smarticleparticle/scent-sync/hardware/CAD/TopHolder1.stl

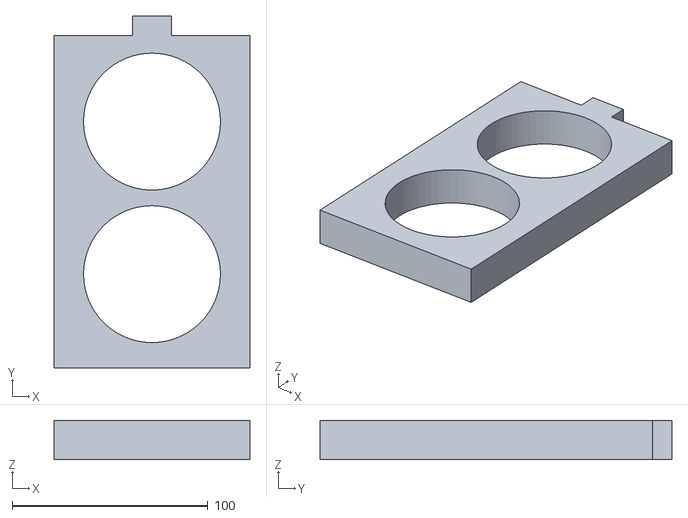
[picture p1: CAD file, 2026-04-13]
hardware/CAD/TopHolder1.stl
100.0 x 180.0 x 20.0
