smarticleparticle/scent-sync/hardware/CAD/BottomHolder2.stl

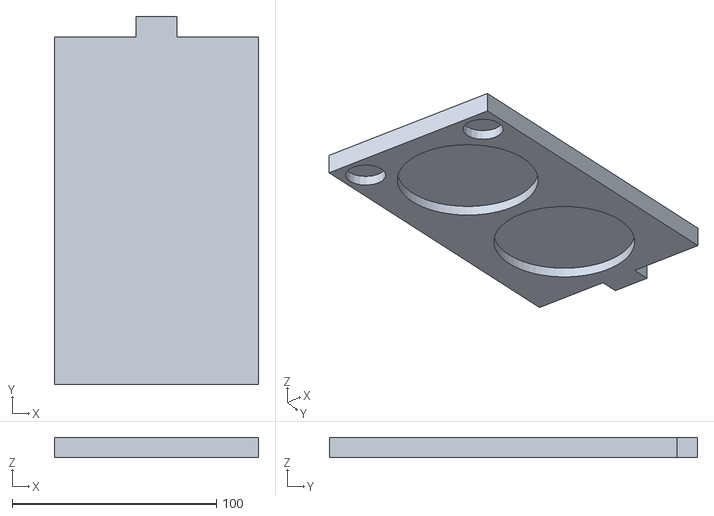
[picture p2: CAD file, 2026-04-13]
hardware/CAD/BottomHolder2.stl
100.0 x 180.0 x 10.0
