smarticleparticle/scent-sync/hardware/CAD/TopHolder2.stl

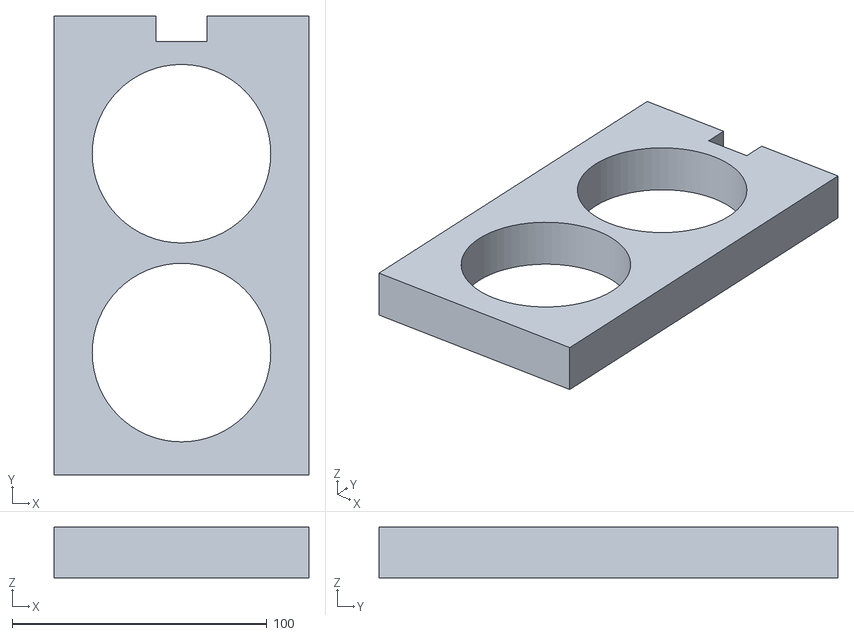
[picture p3: CAD file, 2026-04-13]
hardware/CAD/TopHolder2.stl
100.0 x 180.0 x 20.0
