smarticleparticle/scent-sync/hardware/CAD/BottomHolder1.stl

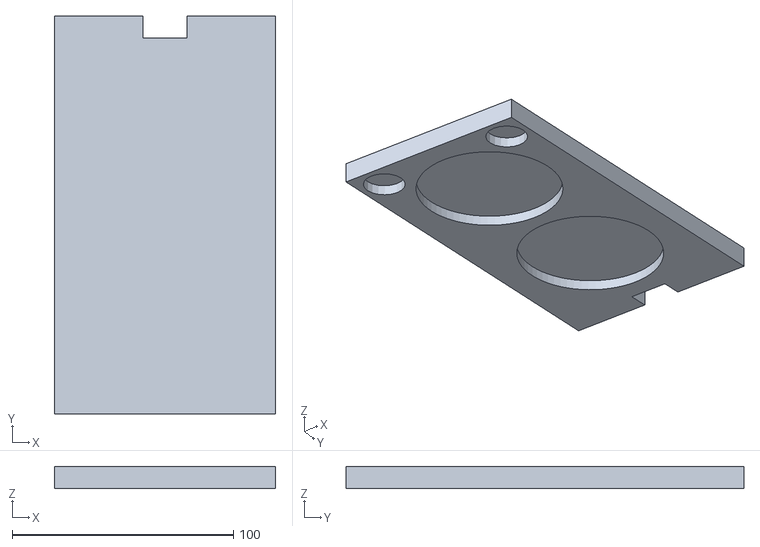
[picture p4: CAD file, 2026-04-13]
hardware/CAD/BottomHolder1.stl
100.0 x 180.0 x 10.0
