smarticleparticle/scent-sync/hardware/CAD/ArduinoCase.stl

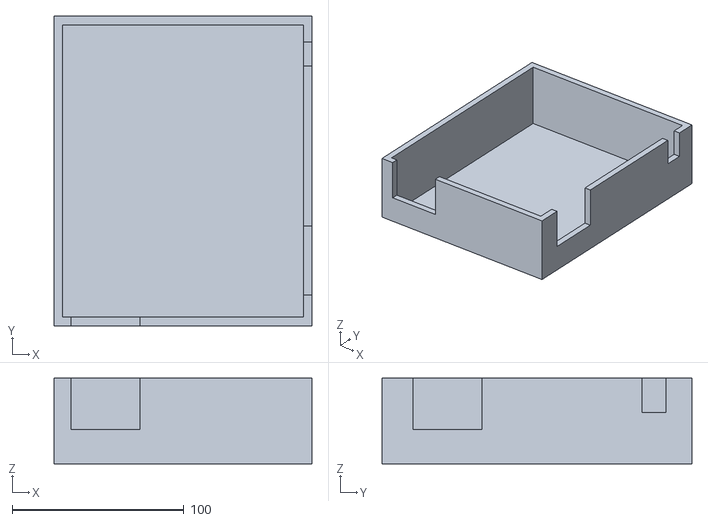
[picture p5: CAD file, 2026-04-13]
hardware/CAD/ArduinoCase.stl
150.0 x 180.0 x 50.0
