smarticleparticle/scent-sync/hardware/CAD/HolderSupport.stl

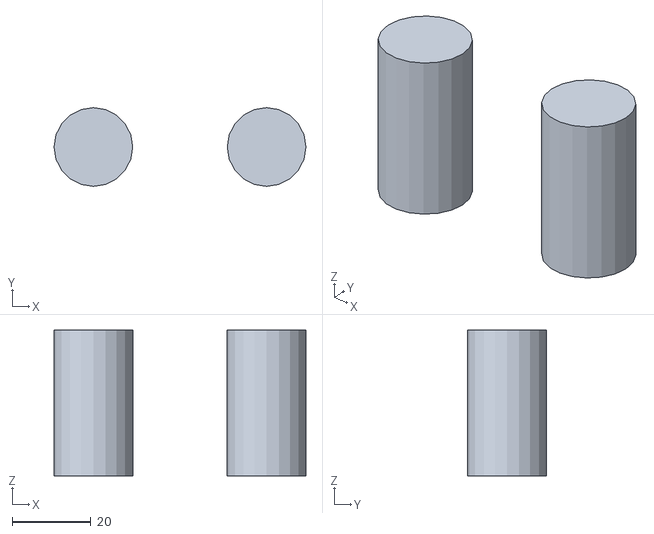
[picture p6: CAD file, 2026-04-13]
hardware/CAD/HolderSupport.stl
64.0 x 20.0 x 37.0
