smarticleparticle/scent-sync/hardware/CAD/Tube_Cap.stl

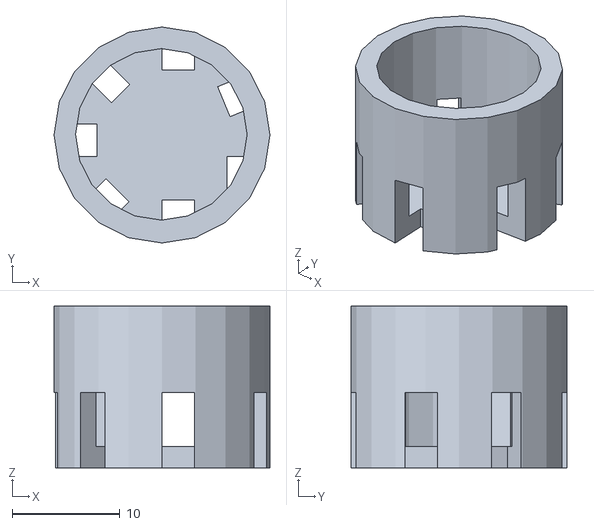
[picture p7: CAD file, 2026-04-13]
hardware/CAD/Tube_Cap.stl
20.0 x 20.0 x 15.0
