smarticleparticle/scent-sync/hardware/schematics/olfactometer_schematic.pdf

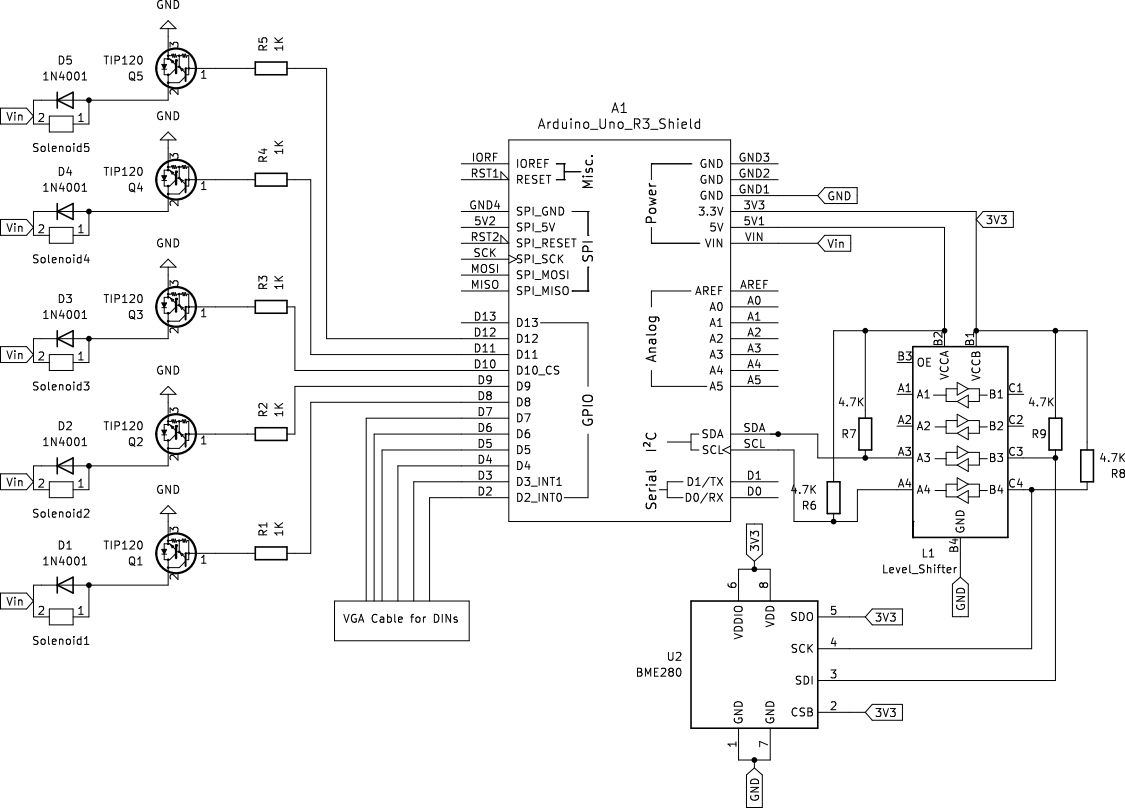
[picture p8: page 1]
