smarticleparticle/scent-sync/analysis/figure_sources/figure1_left_infographic.pdf

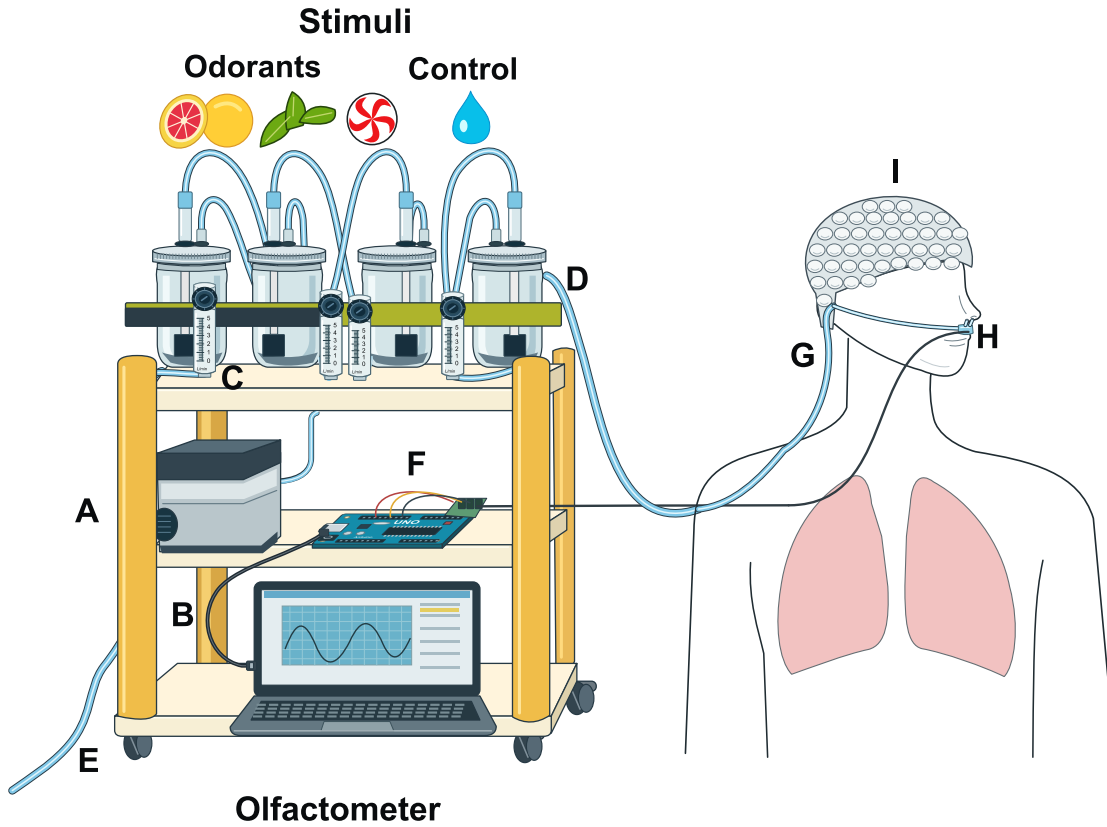
[picture p9: page 1]
