smarticleparticle/scent-sync/(commit log)

2026-04-10 Create BOM.csv
    Bill of Materials
    [BOM.csv]
2026-04-13 Rename hardware/Lid cap slower (3).stl to hardware/cad/tube_cap.stl
    [tube_cap.stl]
2026-04-13 Rename Arduino Case Second version.stl to ArduinoCase.stl
    [ArduinoCase.stl]
2026-04-13 Rename Bottom Half 1.stl to BottomHolder1.stl
    [BottomHolder1.stl]
2026-04-13 Rename Bottom Half 2.stl to BottomHolder2.stl
    [BottomHolder2.stl]
2026-04-13 Rename Top rack part 1.stl to TopHolder1.stl
    [TopHolder1.stl]
2026-04-13 Rename top rack part 2.stl to TopHolder2.stl
    [TopHolder2.stl]
2026-10-23 Add analysis code, figures, tests, data-deposit tools and DOI (#1)
    * Add analysis code, top-level README and citation file
    * CI: point the editable install at the analysis/ subfolder
    * Fix CI: finalize tests use their own templates; restore workflow
    * Fig. 1: hand-made illustration + respiration trace composed as a vector figure
    * CI: skip PyTorch packages and free disk space (runner ran out of space)
    * PDF-only figures, Fig. 1 assembled from the illustration PDF, shorter docs, deposit details
    * PDF-only figures, Fig. 1 assembled from the illustration PDF, shorter docs, deposit details
    * Deposit: 17 analyzed participants only, timing files dropped, no timestamps; deposit config runs w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
    [goodscents_selected.csv]
